sinethuta/nano-fuse-reset/NANO FUSE RESET Instruction Manual v3.pdf

THUTA KYAW | FUSE RESET FOR ATMEGA328/328P

### NANO FUSE RESET Instruction Manual

Introduction

The NANO FUSE RESET uses the Arduino Nano Microcontroller to reset Fuse bytes and erase

Flash and EEPROM for ATMEGA 328/328P. By using the Arduino Nano with a BJT, the device

will reset the Flash Program memory, EEPROM Data memory, Memory Lock bits, and Fuse bits

in the ATMEGA 328/328P using HIGH VOLTAGE PARALLEL PROGRAMMING.

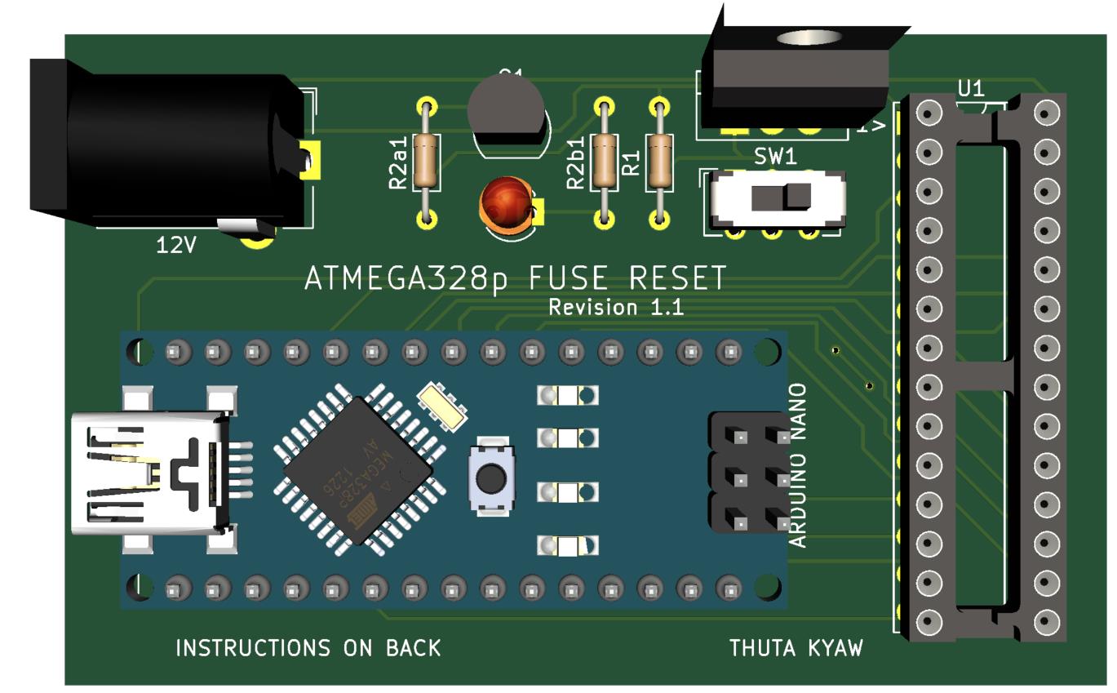
[picture p1: figure]

Figure 1: NANO FUSE RESET Rev. 1.1

Instructions

Insert ATMEGA328/328P

Connect 12V Power

Ready when RED LED stops flashing

DISCONNECT POWER *

SCHEMETIC

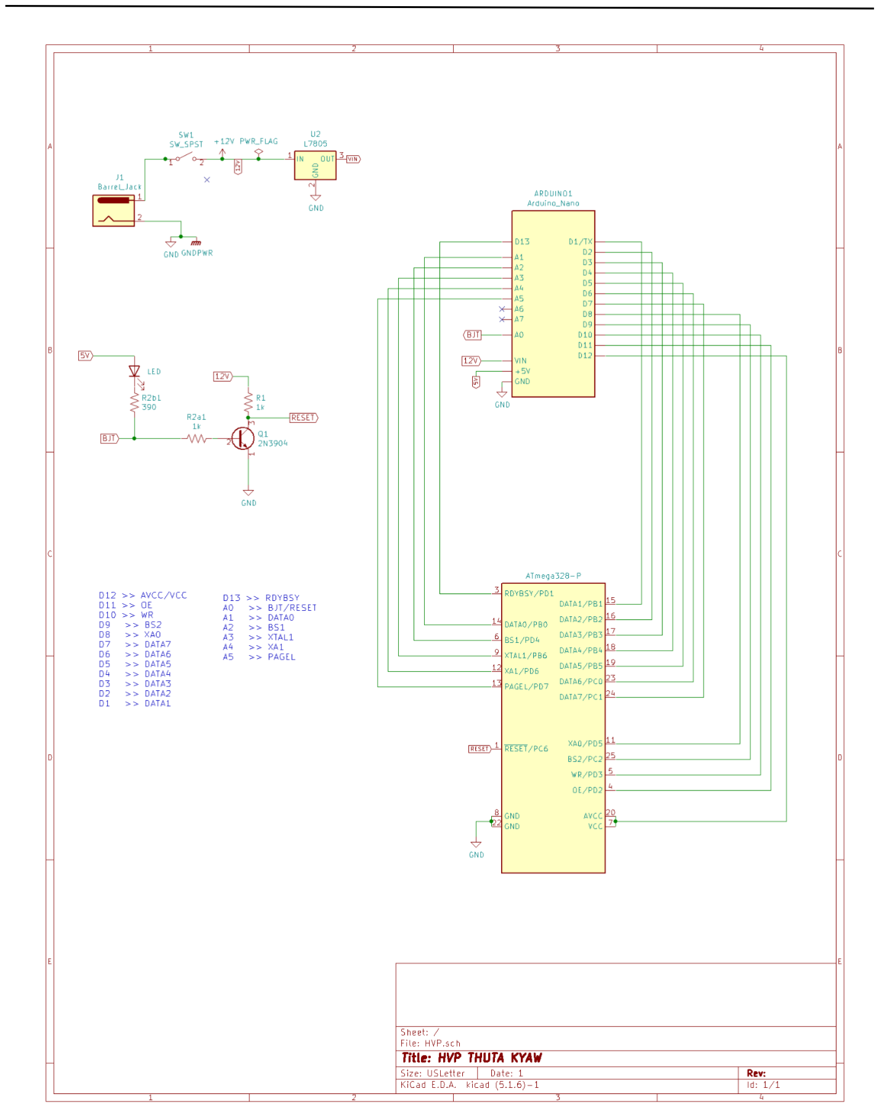
[picture p2: figure]

Notes

*DISCONNECT POWER WHEN UNUSED. For unknown reasons, the voltage regulator on the Arduino Nano (even the original one) burns out even though it is rated for higher than 12V. Added a L7805 5V voltage regulator to avoid damaging the LMS1117 on the Arduino Nano

If there is no power to Arduino, plug in both the USB and 12V to operate the NANO FUSE RESET.

This project is targeted for students who are learning to program their ATMEGA chips. It provides an easy and cheap solution to reprogram misconfigured Fuse/Lock bits.

Learn more about HIGH VOLTAGE PARALLEL PROGRAMMING instructions from Section 28.6 in the ATmega48A/PA/88A/PA/168A/PA/328/P (http://ww1.microchip.com/downloads/en/DeviceDoc/ATmega48A-PA-88A-PA-168A-PA-328-P-DS-DS40002061A.pdf) datasheet.

Hardware Revision History

Revision 1.1

Added Pin 1 label for ATMEGA 328/328P

Added Voltage Regulator

Connected GND to Pin 8 of ATMEGA328/328p

Document Revision History

NANO FUSE RESET Instruction Manual v2. Updated 9.28.2020

All webpages last accessed 5.31.2020
